maslohaslo1234-spec/SpinPOV/BOM.csv

Item | Qty | Supplier | Cost/item | Total Cost | link
APA102/SK9822 LED strip, 144 LED/m, 1 m, IP30 | 1 | AliExpress | $20.72 | $20.72 | https://pl.aliexpress.com/item/32322326979.html?src=google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
MT3608 boost module | 1 | AliExpress | $1.61 | $1.61 | https://pl.aliexpress.com/item/1005007470651963.html?pdp_ext_f=%7B"order"%3A"37"%2C"spu_best_type"%3A"price"%2C"eval"%3A"1"%2C"fromPage"%3A"search"%7D&pdp_npi=6%40dis%21PLN%215.82%215.82%21%21%219.63%219.63%21%400b15834e17934750566176446e0e5a%2112000048160526020%21sea%21PL%216848615415%21X%211%210%21n_tag%3A-29919%3Bd%3A71f28d94%3Bm03_new_user%3A-29895&curPageLogUid=ObZY0ACrHekm&utparam-url=scene%3Asearch%7Cquery_from%3A%7Cx_object_id%3A1005007470651963%7C_p_origin_prod%3A
A3144 Hall sensor | 1 | AliExpress | $2.11 | $2.11 | https://pl.aliexpress.com/item/1005007195591707.html?pdp_ext_f=%7B"order"%3A"1164"%2C"spu_best_type"%3A"price"%2C"eval"%3A"1"%2C"fromPage"%3A"search"%7D&pdp_npi=6%40dis%21PLN%218.46%218.34%21%21%2114.01%2113.80%21%4021613bf617934752013645825e1132%2112000039764717276%21sea%21PL%216848615415%21X%211%210%21n_tag%3A-29919%3Bd%3A71f28d94%3Bm03_new_user%3A-29895&curPageLogUid=iPEizTtG5Fuz&utparam-url=scene%3Asearch%7Cquery_from%3A%7Cx_object_id%3A1005007195591707%7C_p_origin_prod%3A
M2 screws | 1 | AliExpress | $2.21 | $2.21 | https://pl.aliexpress.com/item/1005007838338973.html?pdp_ext_f=%7B"order"%3A"13163"%2C"eval"%3A"1"%2C"fromPage"%3A"search"%7D&pdp_npi=6%40dis%21PLN%218.11%218.11%21%21%2113.43%2113.43%21%402103877917934754720444577e0e8e%2112000042428692862%21sea%21PL%216848615415%21X%211%210%21n_tag%3A-29919%3Bd%3A71f28d94%3Bm03_new_user%3A-29895&curPageLogUid=YoCXPENpDMtO&utparam-url=scene%3Asearch%7Cquery_from%3A%7Cx_object_id%3A1005007838338973%7C_p_origin_prod%3A
Estimated total shipping | 1 |  |  | $1.00
