maslohaslo1234-spec/SpinPOV/cad/STEP/bracket.step

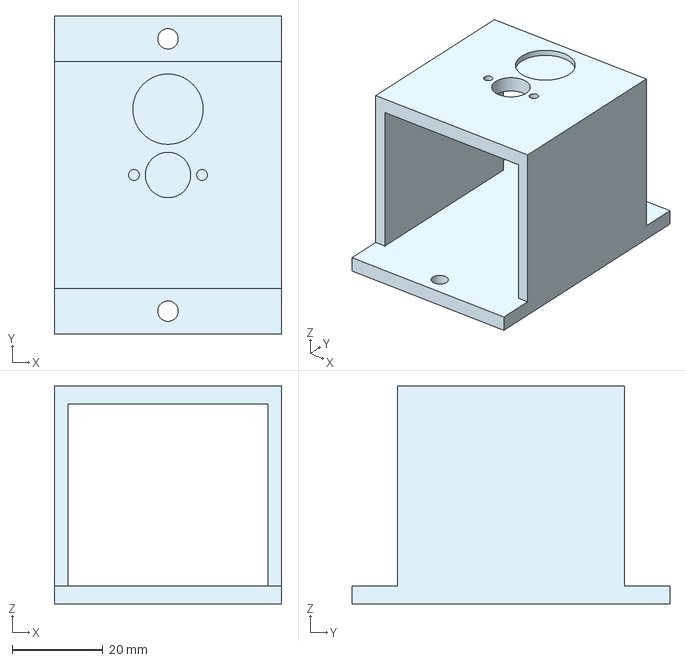
[picture p1: CAD file, 2026-10-31]
cad/STEP/bracket.step
50.0 x 70.0 x 48.0 mm
