maslohaslo1234-spec/SpinPOV/cad/STEP/arm.step

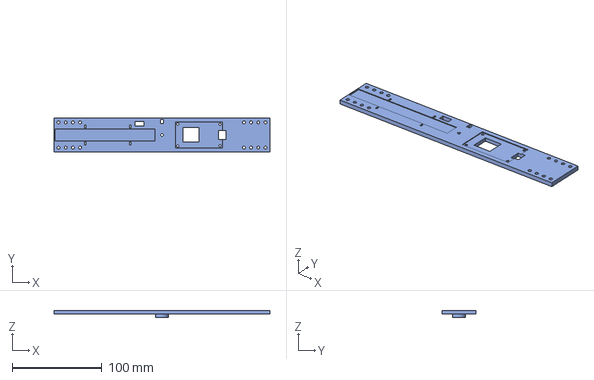
[picture p2: CAD file, 2026-10-31]
cad/STEP/arm.step
240.0 x 38.0 x 8.00 mm
