maslohaslo1234-spec/SpinPOV/cad/STEP/Part Studio 1.step

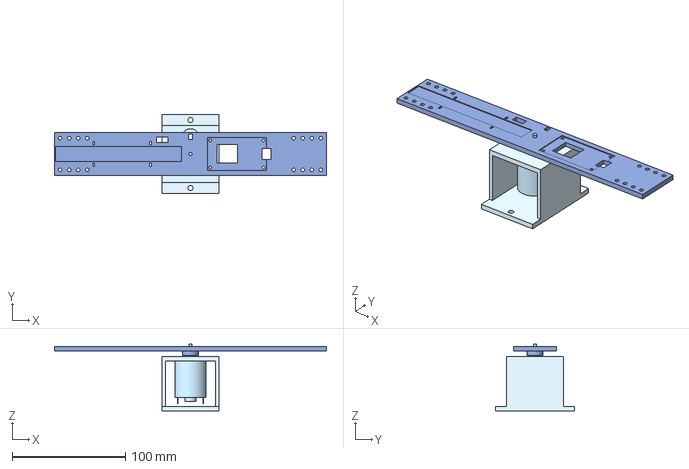
[picture p3: CAD file, 2026-10-31]
cad/STEP/Part Studio 1.step
240.0 x 70.0 x 59.0 mm
