maslohaslo1234-spec/SpinPOV/cad/STEP/motor.step

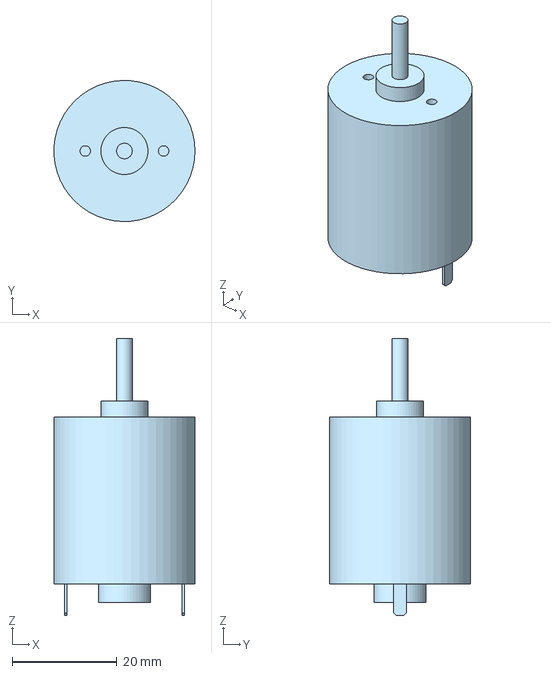
[picture p4: CAD file, 2026-10-31]
cad/STEP/motor.step
27.0 x 27.0 x 53.0 mm
