maslohaslo1234-spec/SpinPOV/(list of files, cad)

Other CAD files:
cad/STL/Part Studio 1.stl
cad/STL/arm.stl
cad/STL/bracket.stl
cad/STL/motor.stl
