maslohaslo1234-spec/SpinPOV/schematic/POV.pdf

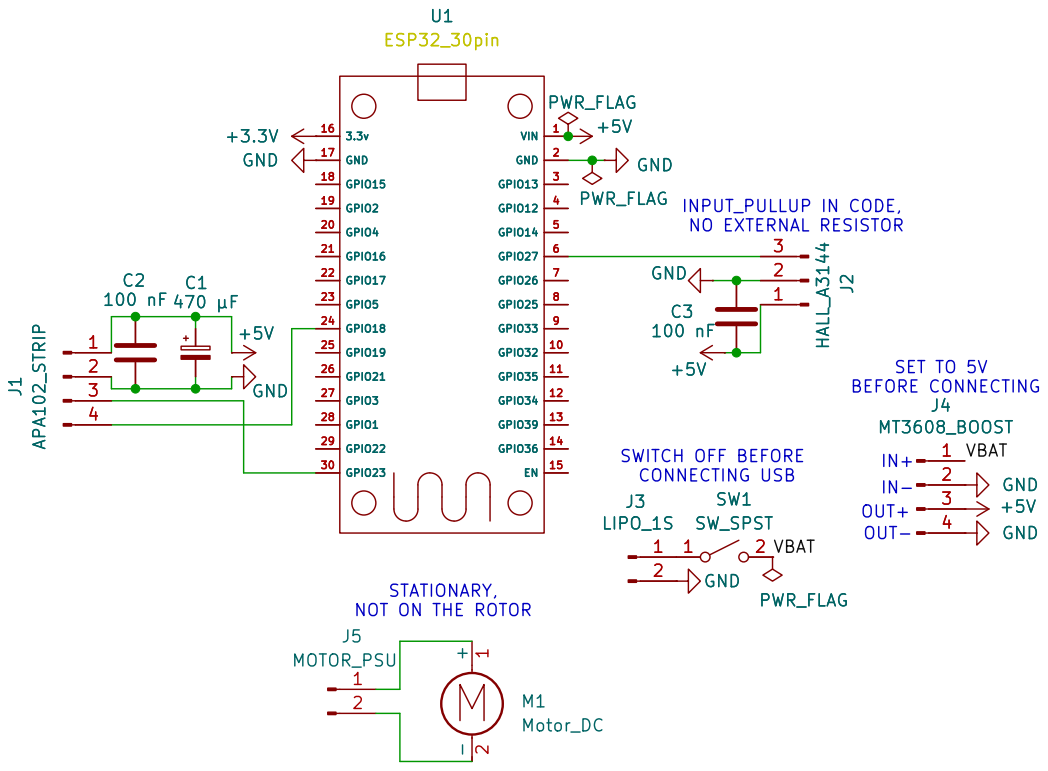
[picture p5: page 1]

INPUT_PULLUP IN CODE, NO EXTERNAL RESISTOR

SET TO 5V BEFORE CONNECTING

STATIONARY, NOT ON THE ROTOR

Size: A4 | Rev:
KiCad E.D.A. 10.0.6 | Id: 1/1
