maslohaslo1234-spec/SpinPOV/schematic/POV.kicad_sch

## KiCad design schematic/POV.kicad_sch (2026-10-31)

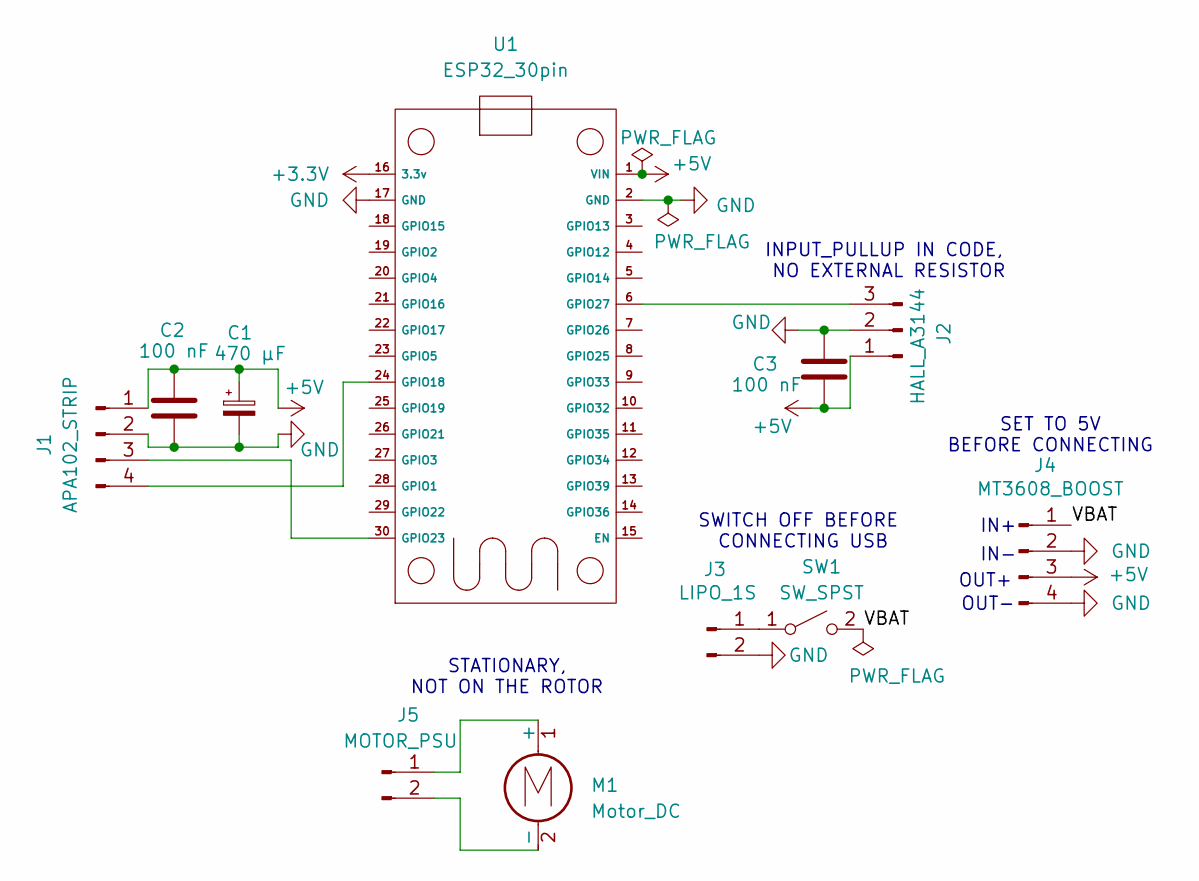
[picture p6: schematic POV.kicad_sch]

Parts:
C1: 470 µF
C2: 100 nF; Xilinx_CSG48_7.0x7.0mm_Layout7x7_P0.8mm
C3: 100 nF
J1: APA102_STRIP; ESP32_30pin
J2: HALL_A3144
J3: LIPO_1S
J4: MT3608_BOOST; ESP32_30pin
J5: MOTOR_PSU
M1: Motor_DC; Maple_Mini
SW1: SW_SPST
U1: ESP32_30pin

Connections:
+3.3V: U1.16 (3.3v)
+5V: C1.1, C2.1, C3.2, J1.1, J2.1, J4.3, U1.1 (VIN)
GND: C1.2, C2.2, C3.1, J1.2, J2.2, J3.2, J4.2, J4.4, U1.2 (GND), U1.17 (GND)
unnamed: J1.3, U1.30 (GPIO23)
unnamed: J1.4, U1.24 (GPIO18)
unnamed: J2.3, U1.6 (GPIO27)
unnamed: J3.1, SW1.1 (A)
unnamed: J5.1, M1.1 (+)
unnamed: J5.2, M1.2 (-)
VBAT: J4.1, SW1.2 (B)

Notes on the sheet:
OUT+
IN+
OUT-
SET TO 5V BEFORE CONNECTING
SWITCH OFF BEFORE CONNECTING USB
STATIONARY, NOT ON THE ROTOR
IN-
INPUT_PULLUP IN CODE, NO EXTERNAL RESISTOR
