maslohaslo1234-spec/SpinPOV/(commit log)

2026-10-28 schematic v1
2026-10-28 Initialize README.md with project details
    Added detailed project description, hardware components, pin connections, and progress tracking for SpinPOV.
2026-10-31 Enhance README with project details and updates
    Updated the README with additional details about the display's mounting, motor speed test results, and progress on the project.
2026-11-01 Sync SpinPOV from Half Life
    [BOM.csv]
